Occulow/occulow-pcb/Occulow-Control.brd

## EAGLE design Occulow-Control.brd (2017-04-12)

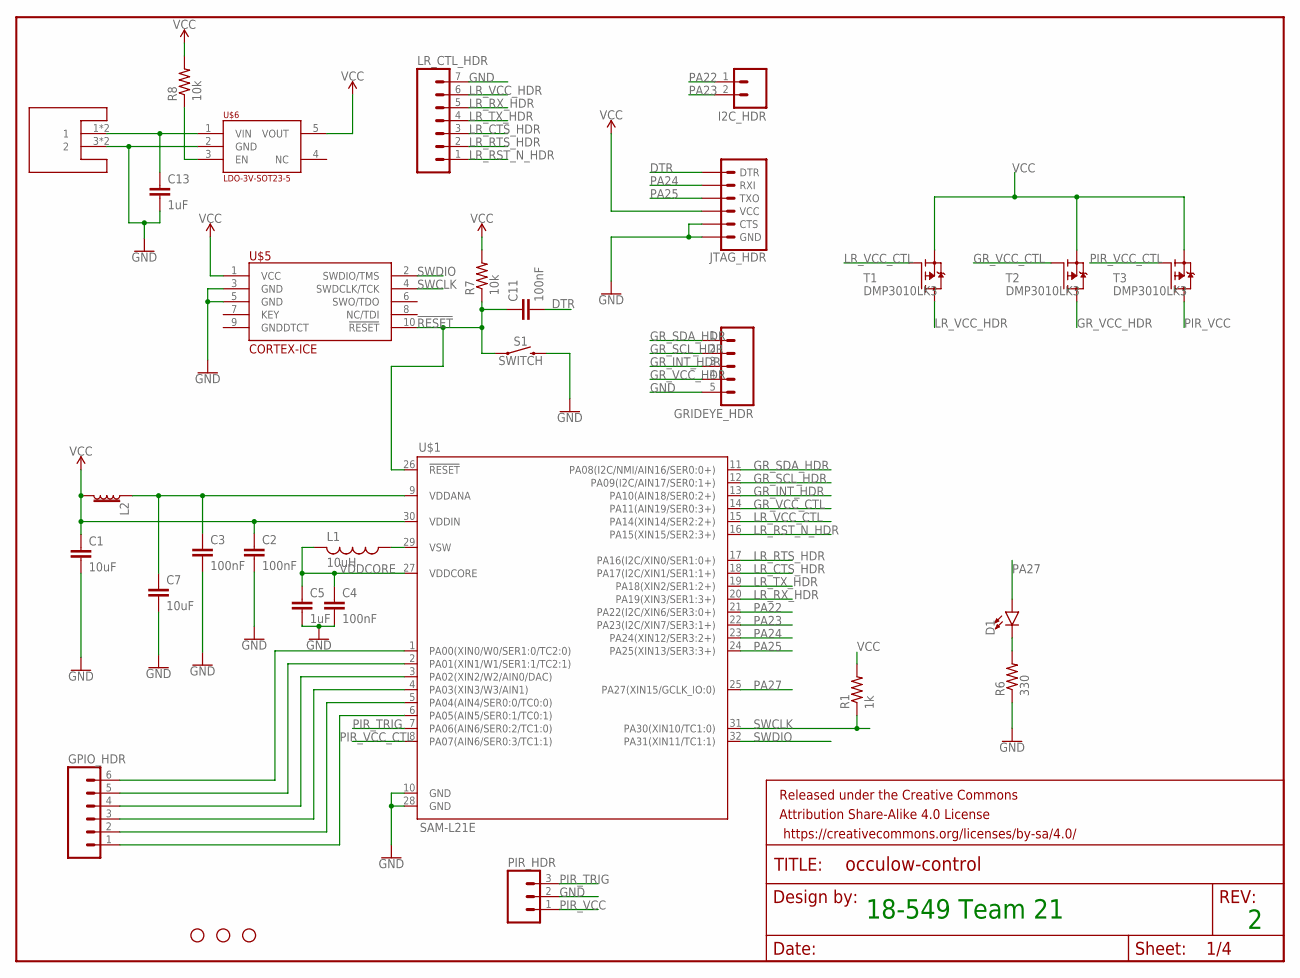
[picture p1: schematic Occulow-Control.sch, sheet 1]

Parts:
C1, C7: 10uF; C1206
C2, C3, C4, C11: 100nF; C1206
C5, C13: 1uF; C1206
D1: LED1206; LED-1206
FRAME1: FRAME-LETTERNO_PACKAGE; DUMMY
GPIO_HDR: M06; 06P
GRIDEYE_HDR: M05; 05P
H1, H2, H3: STAND-OFF
I2C_HDR: M02; 02P
JTAG_HDR: 6_PIN_SERIAL_TARGET; 1X06
L1: 10uH; L3225M
L2: FERRITE_BEAD-0603; 0603
LR_CTL_HDR: M07; 07P
PIR_HDR: M03; 03P
R1: 1k; R1206
R6: 330; R1206
R7, R8: 10k; R1206
S1: SWITCH; TACTILE_SWITCH_SMD_5.2MM
T1, T2, T3: DMP3010LK3; TO252
U$1: SAM-L21E; TQFP32
U$5: CORTEX-ICE; 2X5-1.27MM
U$6: LDO-3V-SOT23-5; SOT23-5L
U$7: MINI-LITE-TRAP

Connections:
!RESET: C11.1, R7.1, S1.1, S1.2 (1), U$1.26 (!RESET), U$5.10 (!RESET)
DTR: C11.2, JTAG_HDR.1 (DTR)
GND: C1.2, C2.2, C3.2, C4.2, C5.2, C7.2, C13.2, GRIDEYE_HDR.5, JTAG_HDR.5 (CTS), JTAG_HDR.6 (GND), LR_CTL_HDR.7, PIR_HDR.2, R6.1, S1.3 (2), S1.4 (2), U$1.10 (GND), U$1.28 (GND), U$5.3 (GND), U$5.5 (GND), U$6.2 (GND), U$7.3 (2), U$7.4 (2)
GR_INT_HDR: GRIDEYE_HDR.3, U$1.13 (PA10(AIN18/SER0:2+))
GR_SCL_HDR: GRIDEYE_HDR.2, U$1.12 (PA09(I2C/AIN17/SER0:1+))
GR_SDA_HDR: GRIDEYE_HDR.1, U$1.11 (PA08(I2C/NMI/AIN16/SER0:0+))
GR_VCC_CTL: T2.1 (G), U$1.14 (PA11(AIN19/SER0:3+))
GR_VCC_HDR: GRIDEYE_HDR.4, T2.3 (D)
LR_CTS_HDR: LR_CTL_HDR.3, U$1.18 (PA17(I2C/XIN1/SER1:1+))
LR_RST_N_HDR: LR_CTL_HDR.1, U$1.16 (PA15(XIN15/SER2:3+))
LR_RTS_HDR: LR_CTL_HDR.2, U$1.17 (PA16(I2C/XIN0/SER1:0+))
LR_RX_HDR: LR_CTL_HDR.5, U$1.20 (PA19(XIN3/SER1:3+))
LR_TX_HDR: LR_CTL_HDR.4, U$1.19 (PA18(XIN2/SER1:2+))
LR_VCC_CTL: T1.1 (G), U$1.15 (PA14(XIN14/SER2:2+))
LR_VCC_HDR: LR_CTL_HDR.6, T1.3 (D)
unnamed: D1.C, R6.2
unnamed: C13.1, U$6.1 (VIN), U$7.1, U$7.2 (1)
unnamed: R8.1, U$6.3 (EN)
PA00: GPIO_HDR.6, U$1.1 (PA00(XIN0/W0/SER1:0/TC2:0))
PA01: GPIO_HDR.5, U$1.2 (PA01(XIN1/W1/SER1:1/TC2:1))
PA02: GPIO_HDR.4, U$1.3 (PA02(XIN2/W2/AIN0/DAC))
PA03: GPIO_HDR.3, U$1.4 (PA03(XIN3/W3/AIN1))
PA04: GPIO_HDR.2, U$1.5 (PA04(AIN4/SER0:0/TC0:0))
PA05: GPIO_HDR.1, U$1.6 (PA05(AIN5/SER0:1/TC0:1))
PA22: I2C_HDR.1, U$1.21 (PA22(I2C/XIN6/SER3:0+))
PA23: I2C_HDR.2, U$1.22 (PA23(I2C/XIN7/SER3:1+))
PA24: JTAG_HDR.2 (RXI), U$1.23 (PA24(XIN12/SER3:2+))
PA25: JTAG_HDR.3 (TXO), U$1.24 (PA25(XIN13/SER3:3+))
PA27: D1.A, U$1.25 (PA27(XIN15/GCLK_IO:0))
PIR_TRIG: PIR_HDR.3, U$1.7 (PA06(AIN6/SER0:2/TC1:0))
PIR_VCC: PIR_HDR.1, T3.3 (D)
PIR_VCC_CTL: T3.1 (G), U$1.8 (PA07(AIN6/SER0:3/TC1:1))
SWCLK: R1.1, U$1.31 (PA30(XIN10/TC1:0)), U$5.4 (SWDCLK/TCK)
SWDIO: U$1.32 (PA31(XIN11/TC1:1)), U$5.2 (SWDIO/TMS)
VCC: C1.1, C2.1, JTAG_HDR.4 (VCC), L2.2, R1.2, R7.2, R8.2, T1.2 (S), T2.2 (S), T3.2 (S), U$1.30 (VDDIN), U$5.1 (VCC), U$6.5 (VOUT)
VDDANA: C3.1, C7.1, L2.1, U$1.9 (VDDANA)
VDDCORE: C4.1, C5.1, L1.2, U$1.27 (VDDCORE)
VSW: L1.1, U$1.29 (VSW)

Notes on the sheet:
18-549 Team 21

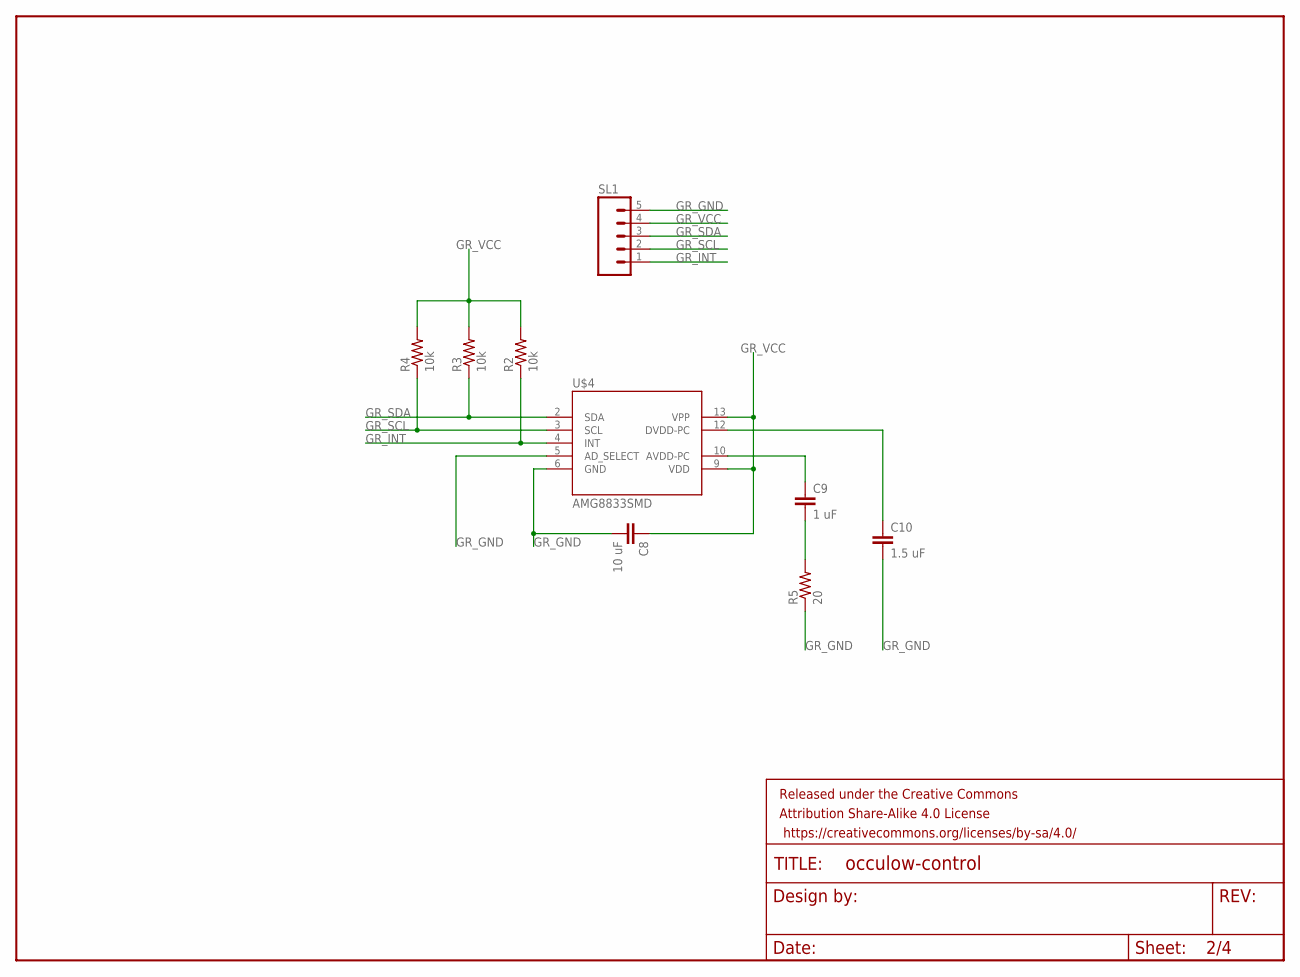
[picture p2: schematic Occulow-Control.sch, sheet 2]

Parts:
C8: 10 uF; C1206
C9: 1 uF; C1206
C10: 1.5 uF; C1206
FRAME2: FRAME-LETTERNO_PACKAGE; DUMMY
R2, R3, R4: 10k; R1206
R5: 20; R1206
SL1: M05; 05P
U$4: AMG8833SMD; AMG8833

Connections:
GR_GND: C8.2, C10.2, R5.1, SL1.5, U$4.5 (AD_SELECT), U$4.6 (GND)
GR_INT: R2.1, SL1.1, U$4.4 (INT)
GR_SCL: R4.1, SL1.2, U$4.3 (SCL)
GR_SDA: R3.1, SL1.3, U$4.2 (SDA)
GR_VCC: C8.1, R2.2, R3.2, R4.2, SL1.4, U$4.9 (VDD), U$4.13 (VPP)
unnamed: C9.1, U$4.10 (AVDD-PC)
unnamed: C9.2, R5.2
unnamed: C10.1, U$4.12 (DVDD-PC)

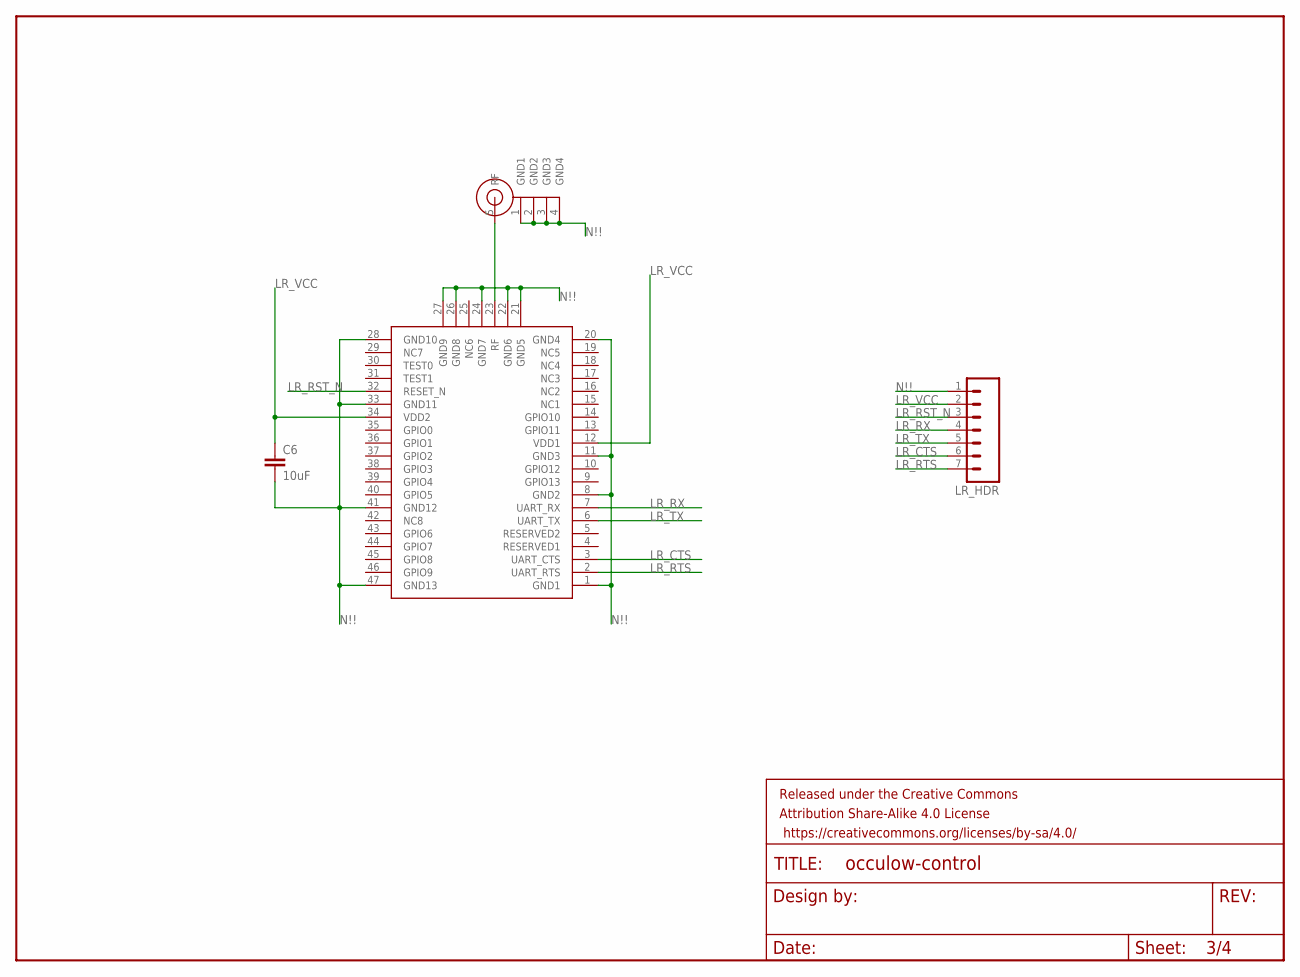
[picture p3: schematic Occulow-Control.sch, sheet 3]

Parts:
C6: 10uF; C1206
FRAME3: FRAME-LETTERNO_PACKAGE; DUMMY
LR_HDR: M07; 07P
U$2: RN2903
U$3: SMA-JACKFEMALE; SMA-JACK

Connections:
LR_CTS: LR_HDR.6, U$2.3 (UART_CTS)
LR_RST_N: LR_HDR.3, U$2.32 (RESET_N)
LR_RTS: LR_HDR.7, U$2.2 (UART_RTS)
LR_RX: LR_HDR.4, U$2.7 (UART_RX)
LR_TX: LR_HDR.5, U$2.6 (UART_TX)
LR_VCC: C6.1, LR_HDR.2, U$2.12 (VDD1), U$2.34 (VDD2)
N!!: C6.2, LR_HDR.1, U$2.1 (GND1), U$2.8 (GND2), U$2.11 (GND3), U$2.20 (GND4), U$2.21 (GND5), U$2.22 (GND6), U$2.24 (GND7), U$2.26 (GND8), U$2.27 (GND9), U$2.28 (GND10), U$2.33 (GND11), U$2.41 (GND12), U$2.47 (GND13), U$3.1 (GND1), U$3.2 (GND2), U$3.3 (GND3), U$3.4 (GND4)
RF: U$2.23 (RF), U$3.5 (RF)

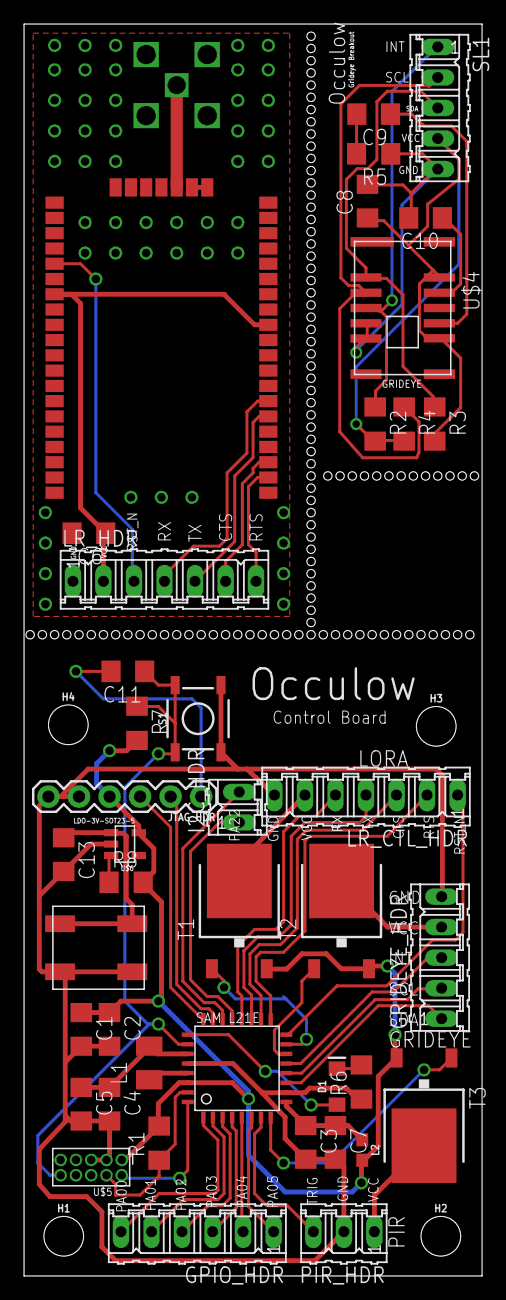
[picture p4: board Occulow-Control.brd from above]

Board: 2 copper layers, 38.1 x 104.1 mm, 49 parts (0 on the bottom side), 54 nets.

Other parts of the board:
H4: STAND-OFF
