Occulow/occulow-pcb/Occulow-Breakout.brd

## EAGLE design Occulow-Breakout.brd (2017-03-02)

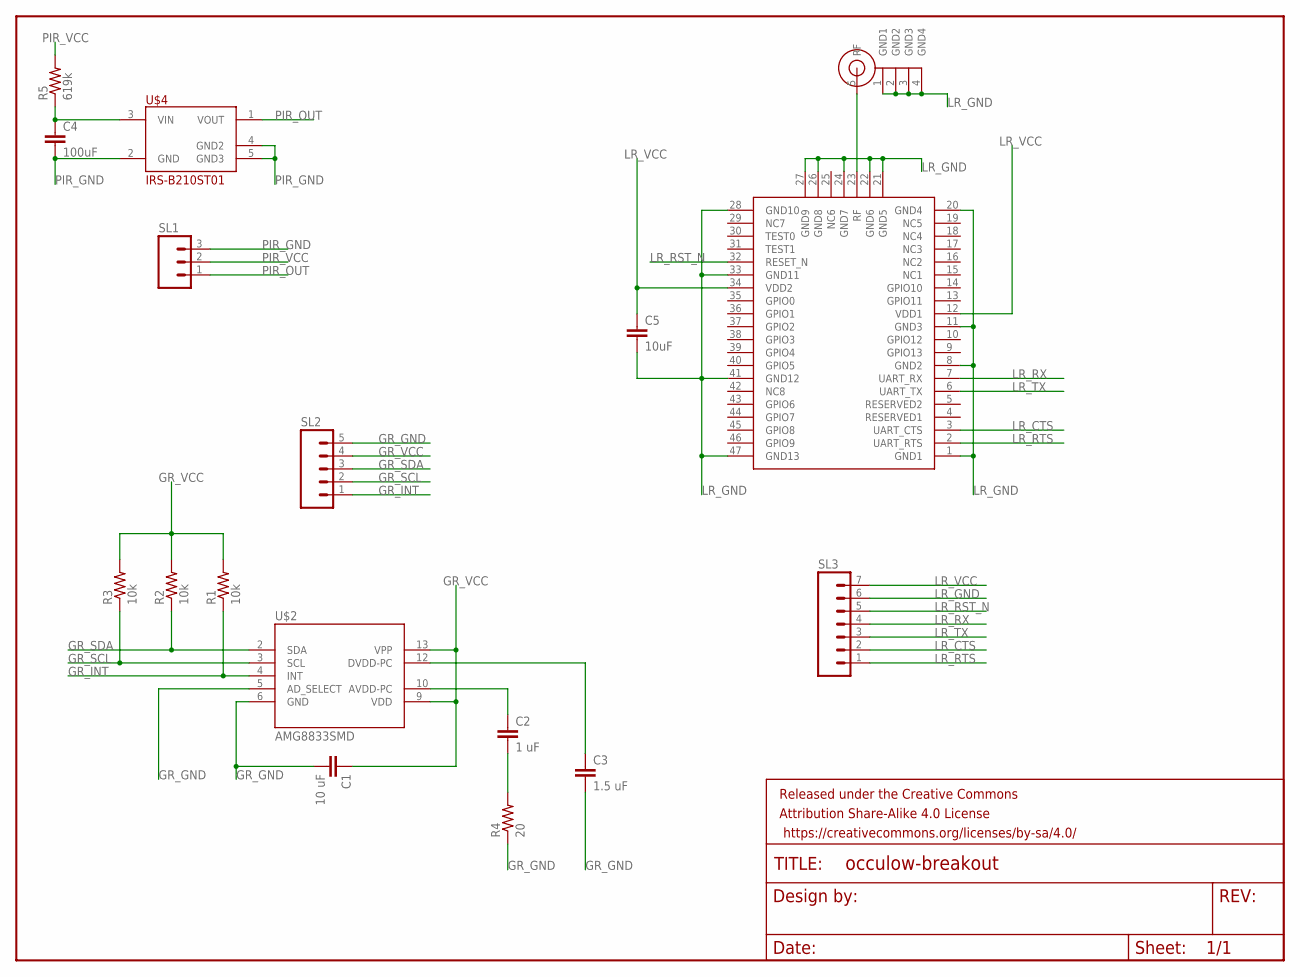
[picture p5: schematic Occulow-Breakout.sch]

Parts:
C1: 10 uF; C1206
C2: 1 uF; C1206
C3: 1.5 uF; C1206
C4: 100uF; C1206
C5: 10uF; C1206
FRAME1: FRAME-LETTER; CREATIVE_COMMONS
R1, R2, R3: 10k; R1206
R4: 20; R1206
R5: 619k; R1206
SL1: M03; 03P
SL2: M05; 05P
SL3: M07; 07P
U$1: RN2903
U$2: AMG8833SMD; AMG8833
U$3: SMA-JACKFEMALE; SMA-JACK
U$4: IRS-B210ST01

Connections:
GR_GND: C1.2, C3.2, R4.1, SL2.5, U$2.5 (AD_SELECT), U$2.6 (GND)
GR_INT: R1.1, SL2.1, U$2.4 (INT)
GR_SCL: R3.1, SL2.2, U$2.3 (SCL)
GR_SDA: R2.1, SL2.3, U$2.2 (SDA)
GR_VCC: C1.1, R1.2, R2.2, R3.2, SL2.4, U$2.9 (VDD), U$2.13 (VPP)
LR_CTS: SL3.2, U$1.3 (UART_CTS)
LR_GND: C5.2, SL3.6, U$1.1 (GND1), U$1.8 (GND2), U$1.11 (GND3), U$1.20 (GND4), U$1.21 (GND5), U$1.22 (GND6), U$1.24 (GND7), U$1.26 (GND8), U$1.27 (GND9), U$1.28 (GND10), U$1.33 (GND11), U$1.41 (GND12), U$1.47 (GND13), U$3.1 (GND1), U$3.2 (GND2), U$3.3 (GND3), U$3.4 (GND4)
LR_RST_N: SL3.5, U$1.32 (RESET_N)
LR_RTS: SL3.1, U$1.2 (UART_RTS)
LR_RX: SL3.4, U$1.7 (UART_RX)
LR_TX: SL3.3, U$1.6 (UART_TX)
LR_VCC: C5.1, SL3.7, U$1.12 (VDD1), U$1.34 (VDD2)
unnamed: C2.1, U$2.10 (AVDD-PC)
unnamed: C2.2, R4.2
unnamed: C3.1, U$2.12 (DVDD-PC)
unnamed: C4.1, R5.1, U$4.3 (VIN)
PIR_GND: C4.2, SL1.3, U$4.2 (GND), U$4.4 (GND2), U$4.5 (GND3)
PIR_OUT: SL1.1, U$4.1 (VOUT)
PIR_VCC: R5.2, SL1.2
RF: U$1.23 (RF), U$3.5 (RF)

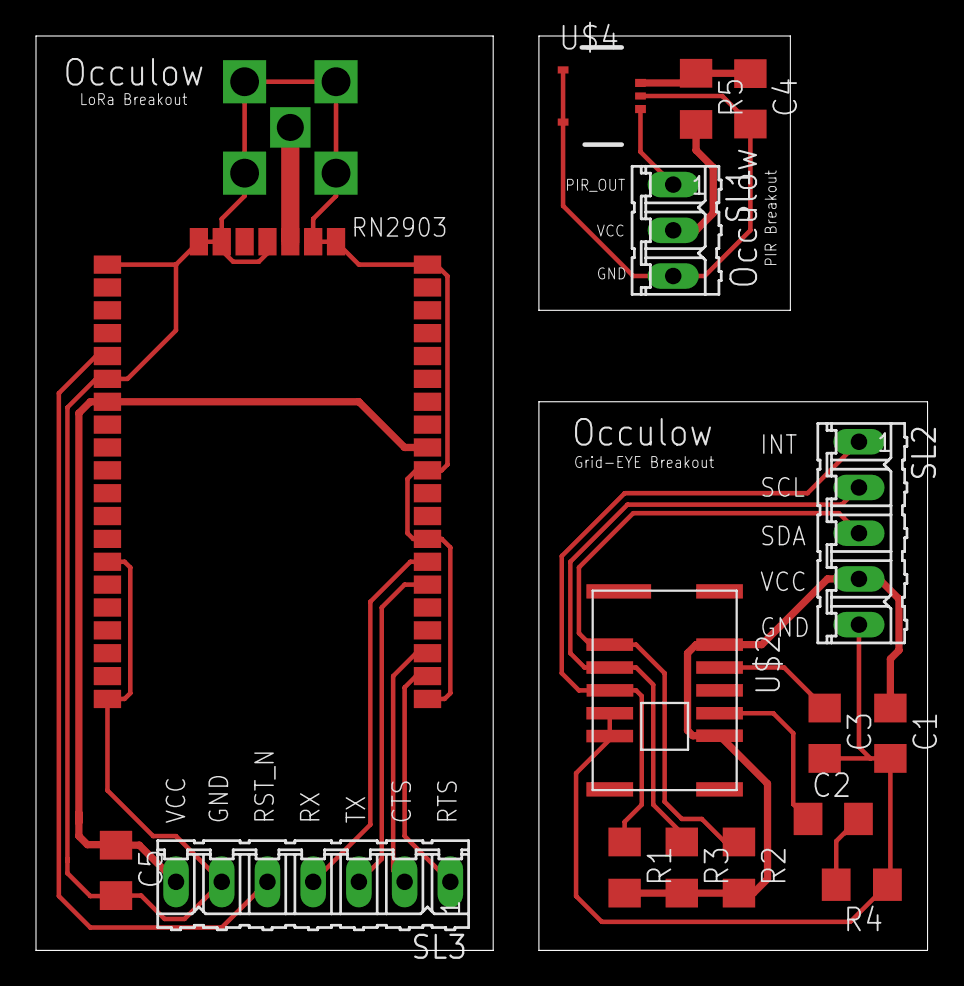
[picture p6: board Occulow-Breakout.brd from above]

Board: 2 copper layers, 49.5 x 50.8 mm, 18 parts (0 on the bottom side), 20 nets.
