Occulow/occulow-pcb/(threads)

Thread 3 (2017-04-10):

Alter ICE debugger through holes

jlbrooks, 2017-04-10:

jlbrooks, 2017-04-10:
Fixed by 7581f94

Closed 2017-04-10.

Thread 9 (2017-04-10):

Move header power lines off of VDDCORE

jlbrooks, 2017-04-10:
Depends on #8, we need to tie the source of each transistor to the regulated 3v3 rather than the VDDCORE output of the internal voltage regulator

Closed 2017-04-10.
