Occulow/occulow-pcb/(commit log)

2017-02-25 Custom libraries, schematic for grideye
    [Occulow-Breakout.sch]
2017-02-25 Added SMA jack, RF connection for LoRa
    [Occulow-Breakout.brd, Occulow-Breakout.sch]
2017-02-26 Added PIR sensor
    [Occulow-Breakout.brd, Occulow-Breakout.sch]
2017-02-26 PIR power circuit
    [Occulow-Breakout.brd, Occulow-Breakout.sch]
2017-02-27 Separate vcc's, headers for all
    [Occulow-Breakout.brd, Occulow-Breakout.sch]
2017-02-28 Removed excessive caps, first pass at layout on 2x2
    [Occulow-Breakout.brd, Occulow-Breakout.sch]
2017-02-28 Ground pins on headers
    [Occulow-Breakout.brd, Occulow-Breakout.sch]
2017-02-28 Routing for lora chip
    [Occulow-Breakout.brd, Occulow-Breakout.sch]
2017-02-28 Routing for grideye
    [Occulow-Breakout.brd, Occulow-Breakout.sch]
2017-02-28 IR sensor layout
    [Occulow-Breakout.brd, Occulow-Breakout.sch]
2017-02-28 Re-named ground for each module
    [Occulow-Breakout.brd, Occulow-Breakout.sch]
2017-02-28 Panelized layout
    [Occulow-Breakout.brd]
2017-02-28 Gerber files
    [Occulow-Breakout.GBL, Occulow-Breakout.GBO, Occulow-Breakout.GBS, Occulow-Breakout.GTL, Occulow-Breakout.GTO, Occulow-Breakout.GTP, Occulow-Breakout.GTS]
2017-02-28 Labels for PIR header, rearranged
    [Occulow-Breakout.brd]
2017-02-28 lora breakout labels
    [Occulow-Breakout.brd]
2017-02-28 Rearrangements and labeling
    [Occulow-Breakout.brd]
2017-02-28 Re-generate gerbers
    [Occulow-Breakout.GBL, Occulow-Breakout.GBS, Occulow-Breakout.GTL, Occulow-Breakout.GTO, Occulow-Breakout.GTP, Occulow-Breakout.GTS]
2017-03-01 Rename caps, bom
    [Occulow-Breakout.brd, Occulow-Breakout.sch, bom.csv]
2017-03-01 Correct reset for lora
    [Occulow-Breakout.brd, Occulow-Breakout.sch]
2017-03-02 Added tplace layer for grideye
    [Occulow-Breakout.brd, Occulow-Breakout.sch]
2017-03-02 Update gerbers
    [Occulow-Breakout.GTL, Occulow-Breakout.GTO]
2017-03-02 Re-route reset, no vias
    [Occulow-Breakout.brd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]
2017-03-20 Created l21 library
    [Occulow-Control.sch]
2017-03-22 Updated sam lbr to ease schematic dev
    [Occulow-Control.sch]
2017-03-23 Start of power circuit for sam chip
    [Occulow-Control.sch]
2017-03-23 Port lora module
    [Occulow-Control.sch]
2017-03-24 Lora and SAM chip integrated
    [Occulow-Control.sch]
2017-03-24 Split boms, started bom for control
    [bom-breakout.csv, bom-control.csv]
2017-03-24 Moved lora off i2c pins, grideye header
    [Occulow-Control.sch]
2017-03-25 PIR control header, unused gpio to header
    [Occulow-Control.sch]
2017-03-25 Moved header pins around, serial debugger header, JST connector
    [Occulow-Control.sch]
2017-03-25 Inductor on VSW for switching power mode
    [Occulow-Control.sch]
2017-03-26 Fixed power filtering circuit
    [Occulow-Control.sch]
2017-03-26 Ferrite bead, changed inductor package
    [Occulow-Control.sch]
2017-03-27 Modified assignments to ease layout
    [Occulow-Control.sch]
2017-03-27 First pass at board
    [Occulow-Control.brd]
2017-03-27 routed unused header
    [Occulow-Control.brd]
2017-03-27 Grideye, PIR, most power routing
    [Occulow-Control.brd, Occulow-Control.sch]
2017-03-27 First pass at full routing
    [Occulow-Control.brd]
2017-03-27 Moved center
    [Occulow-Control.brd]
2017-03-27 Added vias for RF
    [Occulow-Control.brd]
2017-03-28 Changed to breakouts, added sheets
    [Occulow-Control.sch]
2017-03-28 SAM portion fully routed
    [Occulow-Control.brd, Occulow-Control.sch]
2017-03-28 Lora routed
    [Occulow-Control.brd]
2017-03-28 All routed
    [Occulow-Control.brd]
2017-03-28 Added holes for panelization
    [Occulow-Control.brd]
2017-03-28 Added vias on lora breakout
    [Occulow-Control.brd]
2017-03-28 Attempted to slim down grideye board
    [Occulow-Control.brd]
2017-03-28 Moved grideye to the top, added more perforation holes
    [Occulow-Control.brd]
2017-03-29 Ground plane
    [Occulow-Control.brd]
2017-03-30 Labels for most headers, moved some ground vias
    [Occulow-Control.brd, Occulow-Control.sch]
2017-03-30 Nice titles
    [Occulow-Control.brd]
2017-03-31 Control gerber files
    [Occulow-Control.GBL, Occulow-Control.GBO, Occulow-Control.GBS, Occulow-Control.GTL, Occulow-Control.GTO, Occulow-Control.GTP, Occulow-Control.GTS]
2017-04-10 Move schematic grideye pins to i2c pads, fixes #2
    [Occulow-Control.brd, Occulow-Control.sch]
2017-04-10 Updated debug header, re-routed grideye header
    [Occulow-Control.brd, Occulow-Control.sch]
2017-04-10 No VDDCORE power, all vcc. Fixes #9
    [Occulow-Control.brd, Occulow-Control.sch]
2017-04-10 Added LED status, bom. Fixes #6"
    [Occulow-Control.brd, Occulow-Control.sch, bom-control.csv]
2017-04-11 Added vcc pull up for reset and button switch. Fixes #7
    [Occulow-Control.brd, Occulow-Control.sch, bom-control.csv]
2017-04-11 Replaced extra header with JTAG and i2c headers. Fixes #4
    [Occulow-Control.brd, Occulow-Control.sch]
2017-04-12 Created 2 wire trap lib, placed in schematic
    [Occulow-Control.brd, Occulow-Control.sch]
2017-04-12 Added lib for ldo voltage regulator, placed in schematic. No layout
    [Occulow-Control.brd, Occulow-Control.sch]
2017-04-12 Added pull-up for ldo enable
    [Occulow-Control.brd, Occulow-Control.sch]
2017-04-12 Routed voltage regulator and new power connector
    [Occulow-Control.brd, Occulow-Control.sch]
2017-04-12 Update bom
    [bom-control.csv]
2017-04-12 Generate gerber files
    [Occulow-Control.GBL, Occulow-Control.GBS, Occulow-Control.GTL, Occulow-Control.GTO, Occulow-Control.GTP, Occulow-Control.GTS]
